robertyt33/TinyTapeout-ECE298A/Simulations/Pre-Layout/SPICE Simulation.pdf

# Pre-layout

## Step 0. Baseline Analysis

*Need PDK to get more precise simulation, and fine tune parameters, PDK was not working on my computer for some reason
Wpd = 0.84, Wax = 0.42, Wpu = 0.42
(Access width: 0.42; PMOS: 0.42; NMOS: 0.84, CR=2.0, PR=1.0)

### 1bit_sram_read.spice

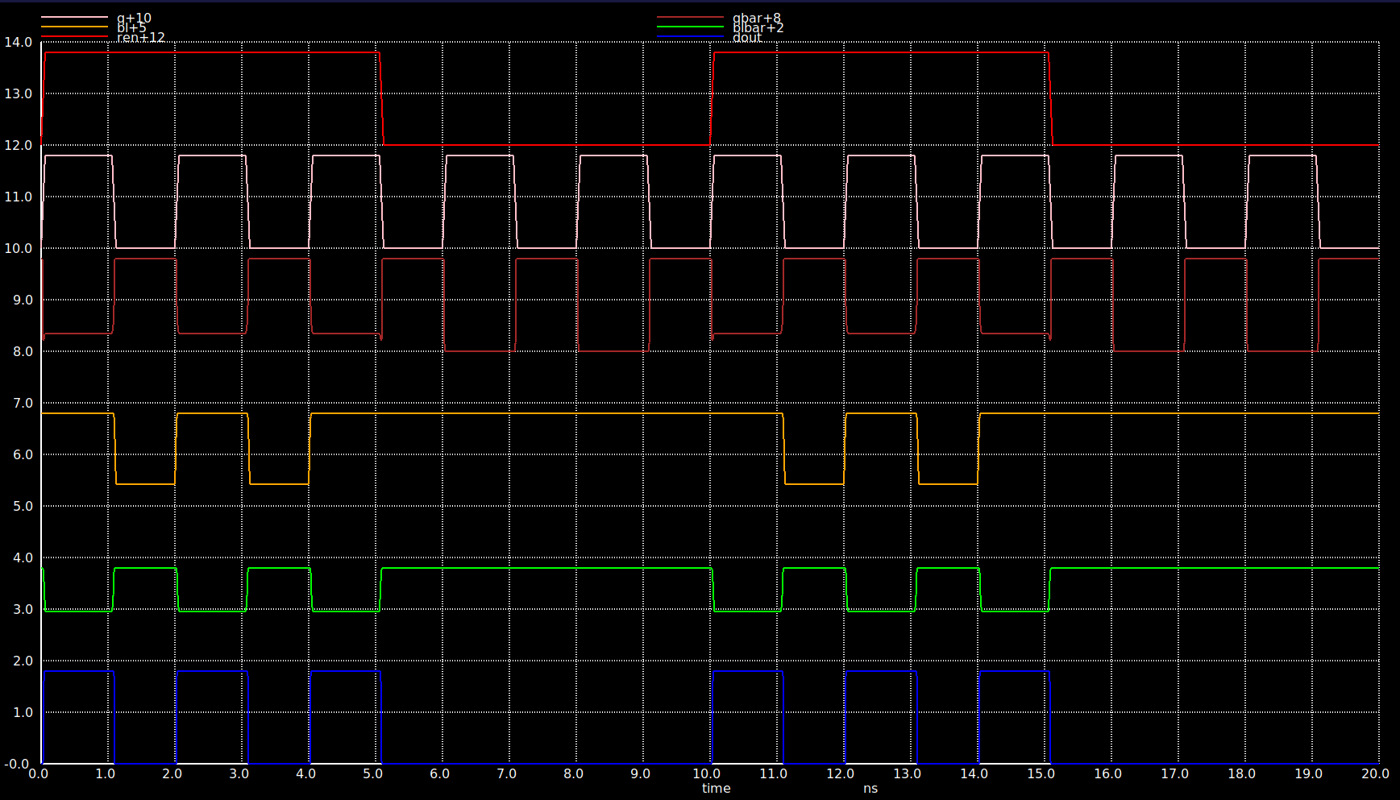
[picture p16: figure]
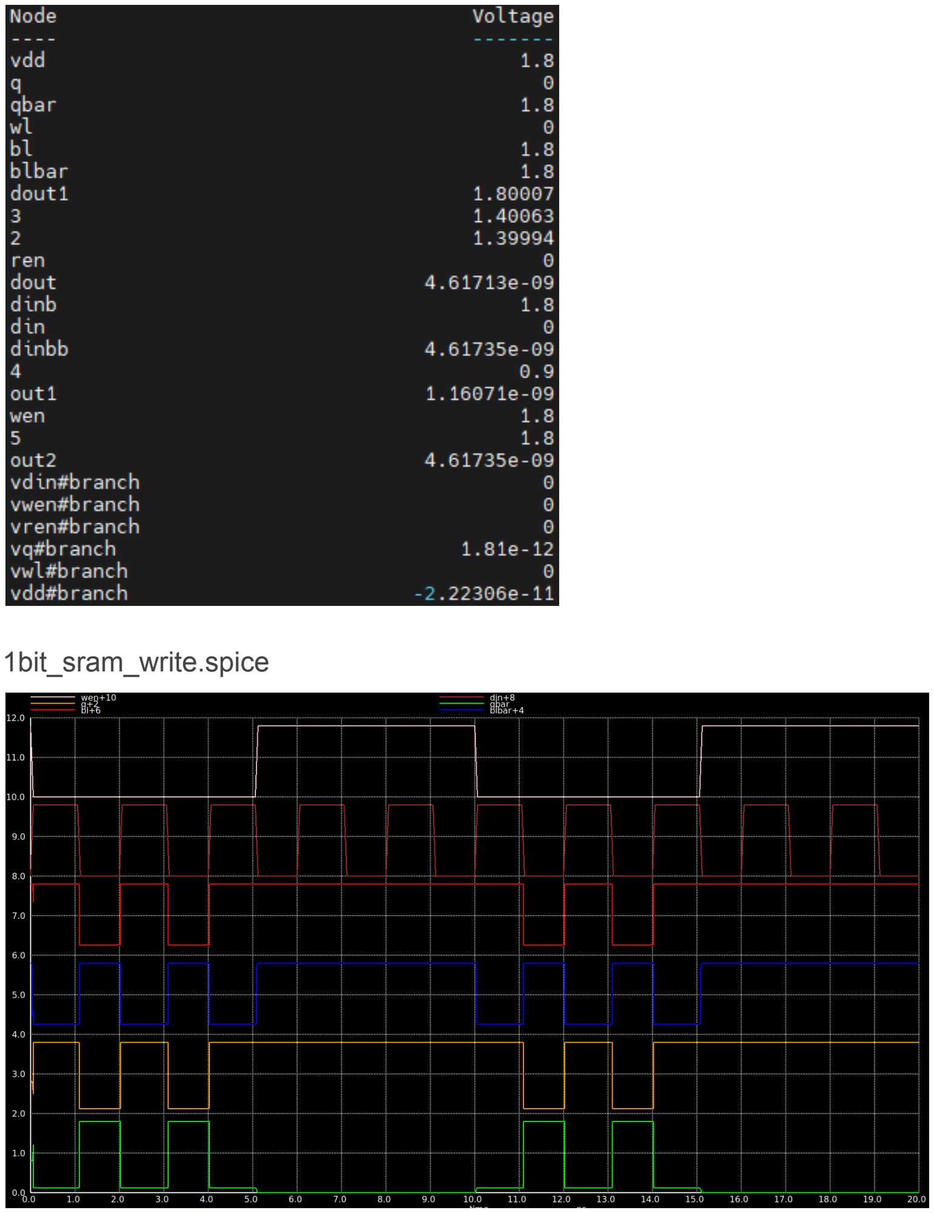
[picture p17: page 2]

### 1bit_sram_write.spice

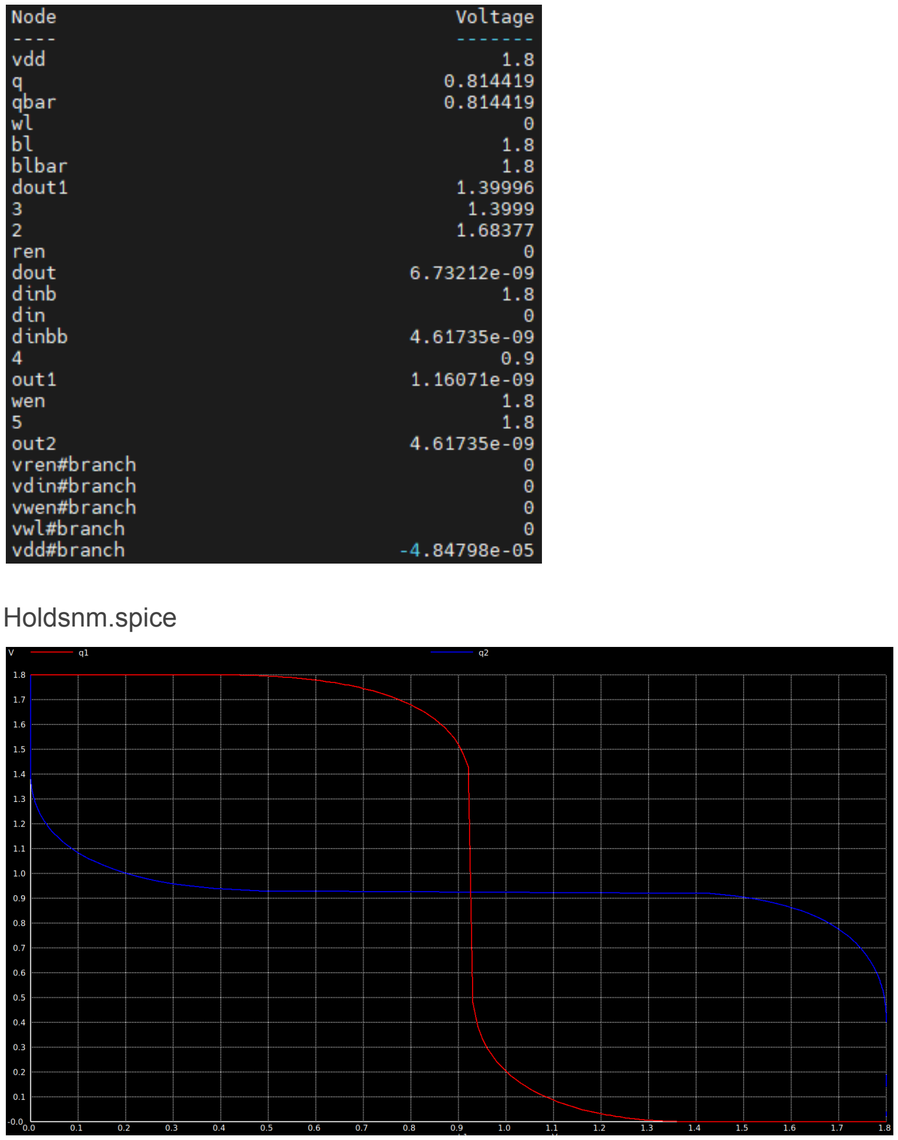
[picture p18: page 3]

### Holdsnm.spice

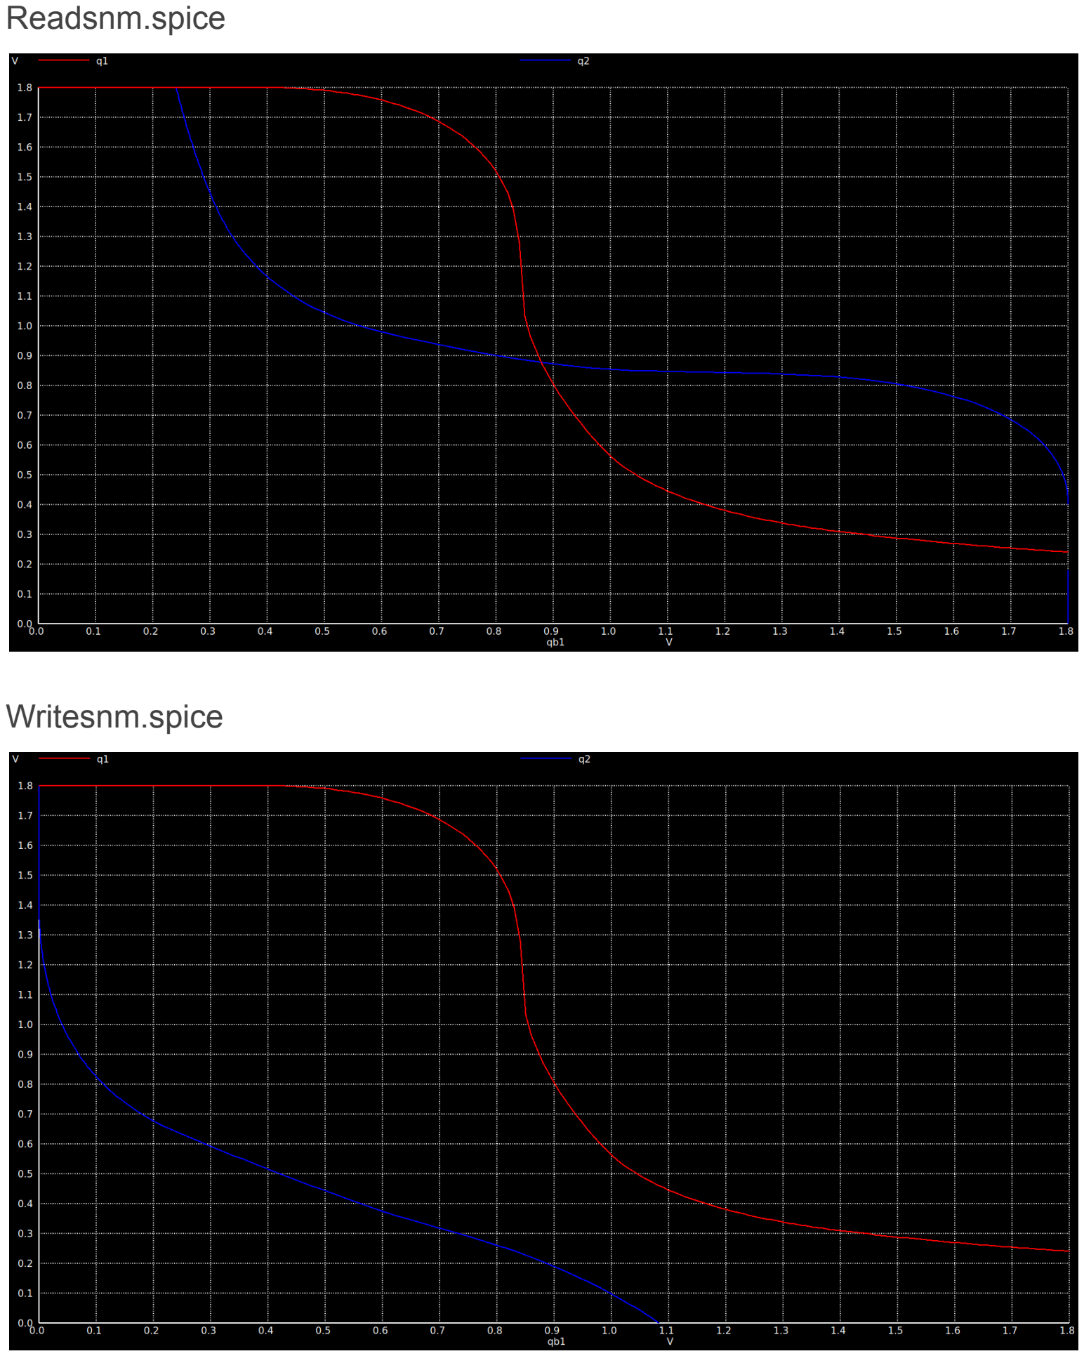
[picture p19: page 4]

### Readsnm.spice

### Writesnm.spice

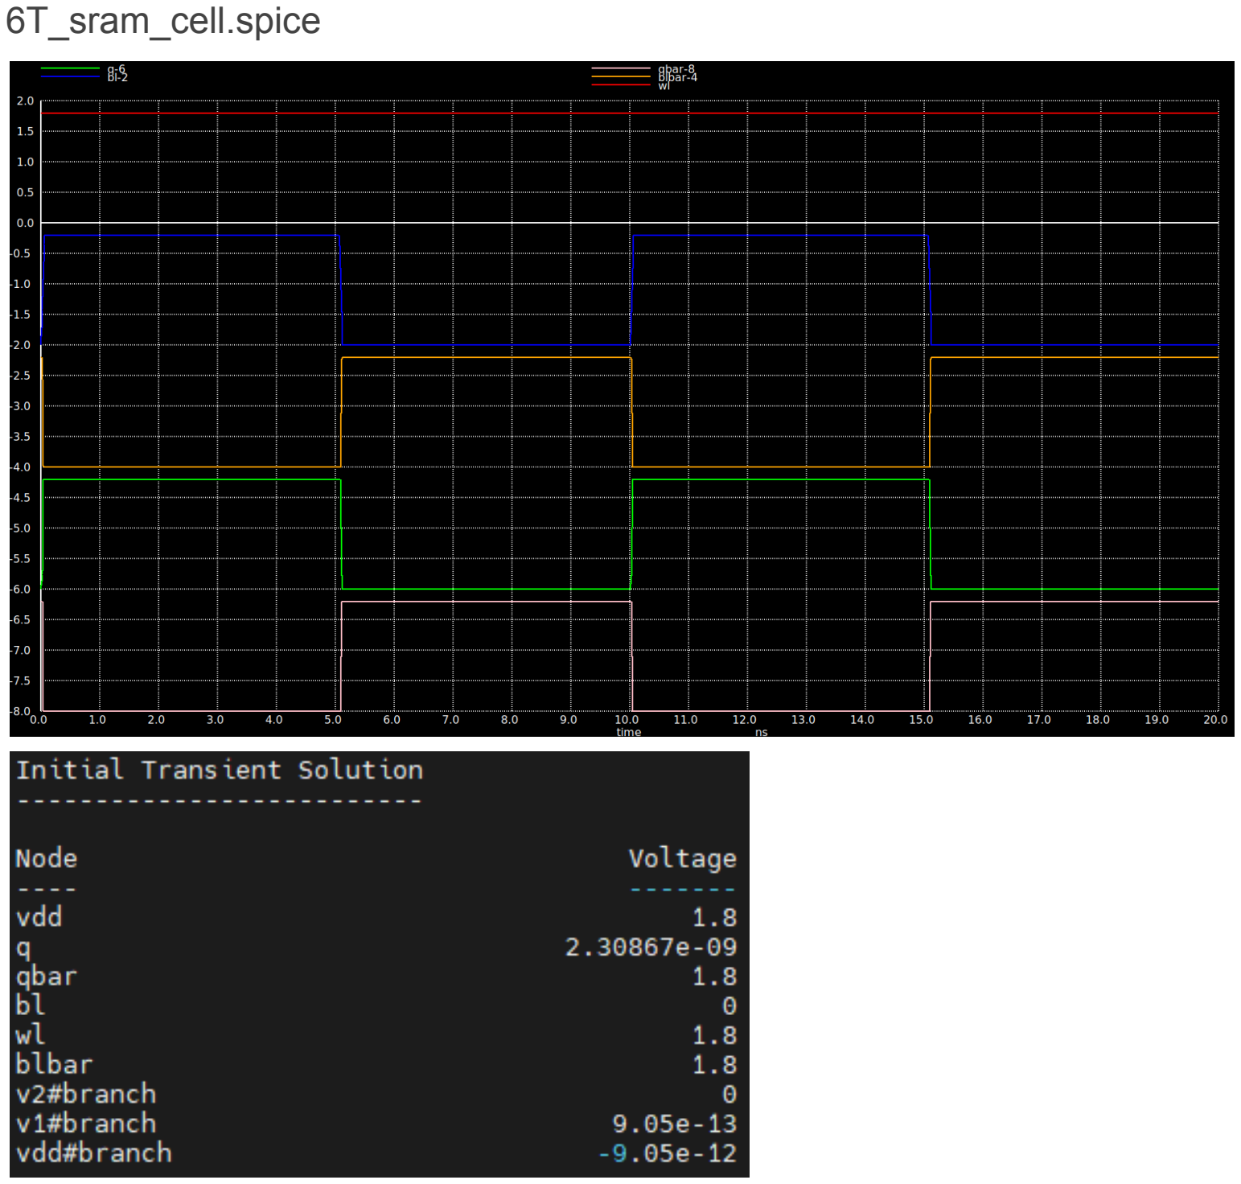
[picture p20: page 5]

### 6T_sram_cell.spice
