robertyt33/TinyTapeout-ECE298A/docs/image.png

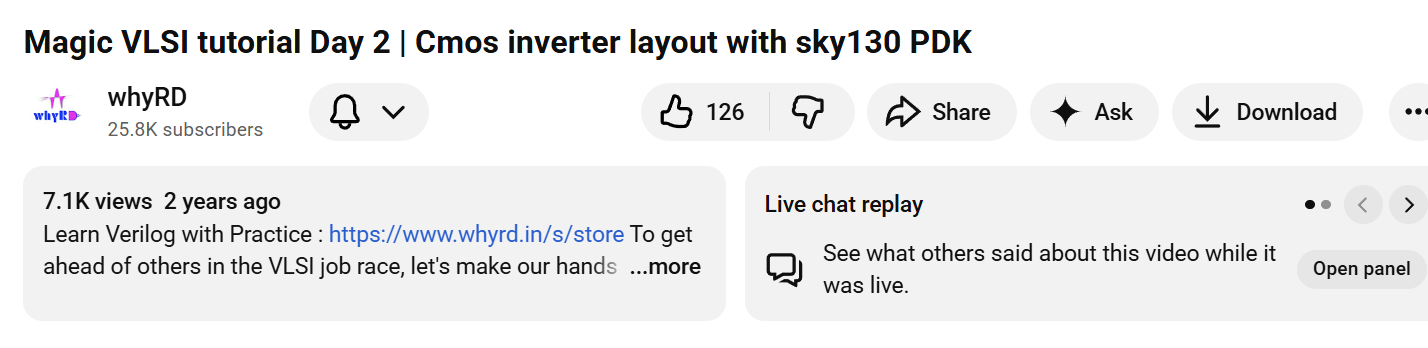
docs/image.png
