robertyt33/TinyTapeout-ECE298A/Schematics/holdsnm.png

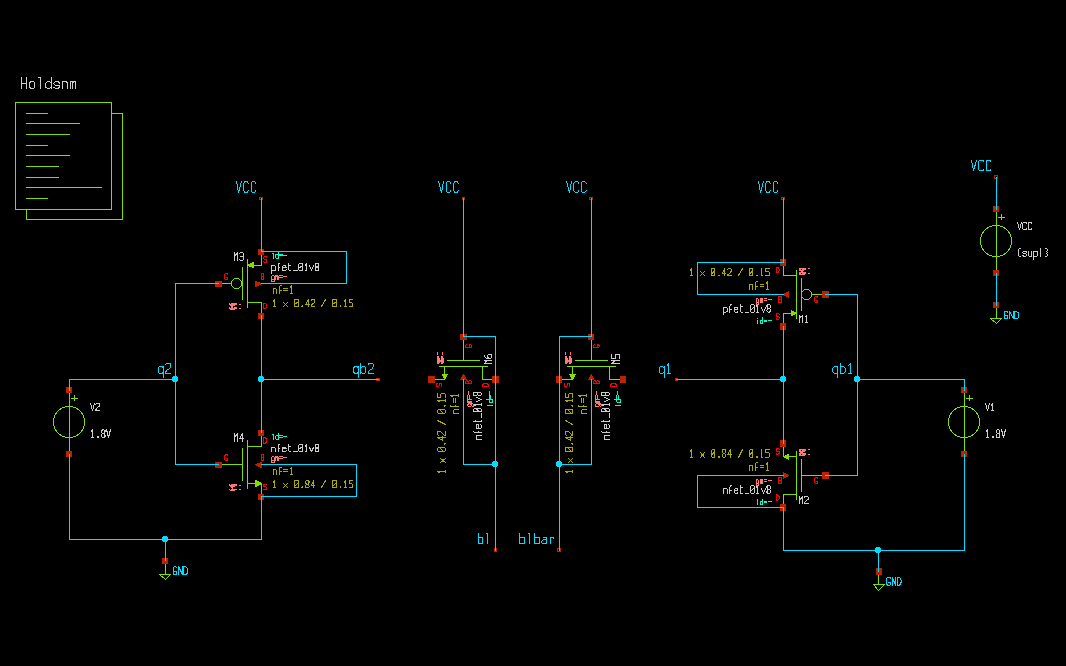
Schematics/holdsnm.png
