robertyt33/TinyTapeout-ECE298A/Simulations/Post-Layout/Timing/plot_read_timing_500f.png

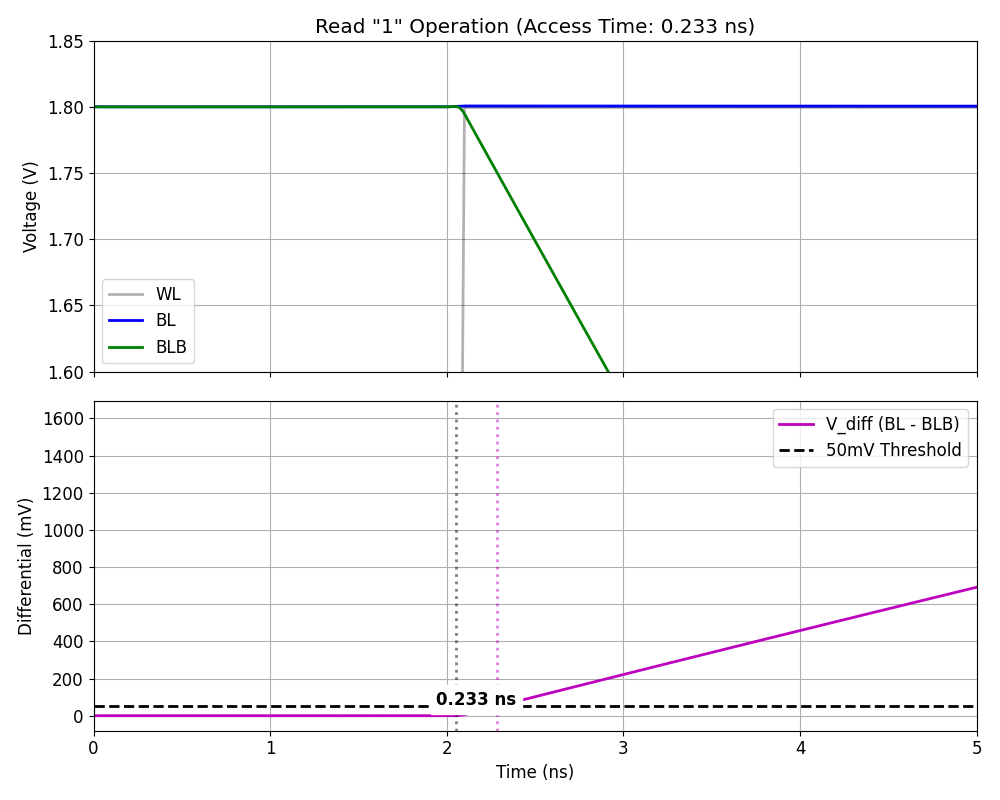
Simulations/Post-Layout/Timing/plot_read_timing_500f.png
