robertyt33/TinyTapeout-ECE298A/Simulations/Post-Layout/Timing/plot_read_timing_1000f.png

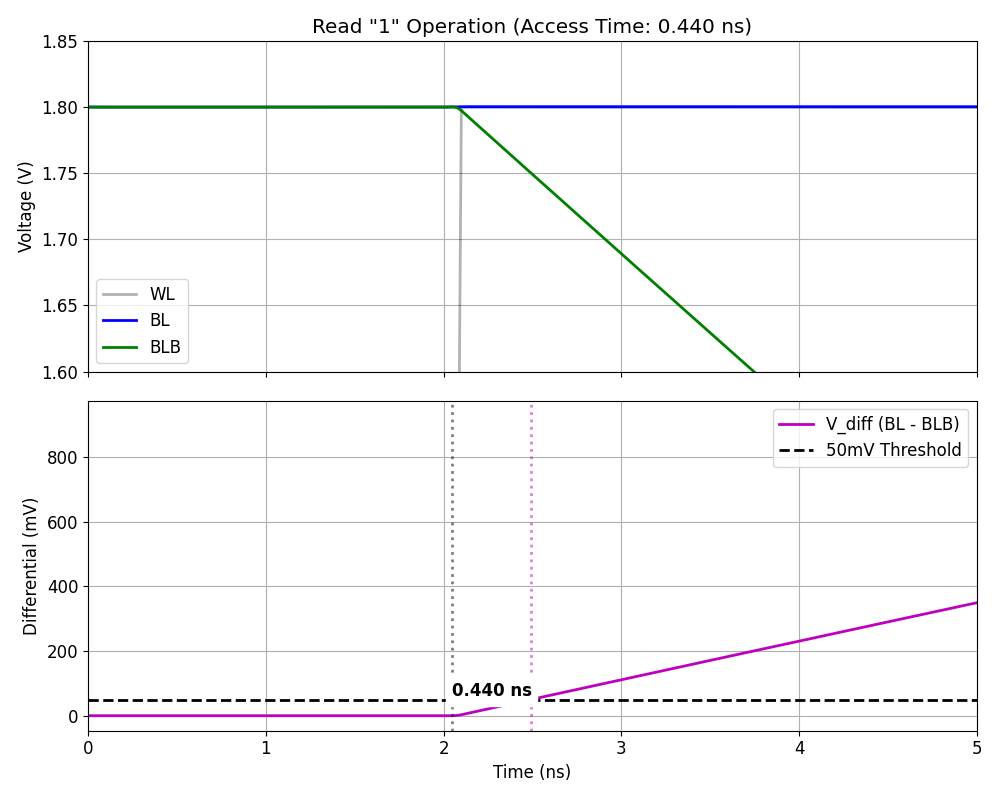
Simulations/Post-Layout/Timing/plot_read_timing_1000f.png
