robertyt33/TinyTapeout-ECE298A/Simulations/Post-Layout/Testbench/6T_SRAM_1bit.spice

* NGSPICE file created from 6T_SRAM_1bit.ext - technology: sky130A

.subckt x6T_SRAM_1bit bl blbar qbar q vdd gnd wl
X0 qbar q gnd gnd sky130_fd_pr__nfet_01v8 ad=0.3528 pd=2.52 as=0.3528 ps=2.52 w=0.84 l=0.18
X1 q wl bl gnd sky130_fd_pr__nfet_01v8 ad=0.1512 pd=1.56 as=0.1512 ps=1.56 w=0.42 l=0.24
X2 q qbar gnd gnd sky130_fd_pr__nfet_01v8 ad=0.3528 pd=2.52 as=0.3528 ps=2.52 w=0.84 l=0.18
X3 qbar q vdd vdd sky130_fd_pr__pfet_01v8 ad=0.1764 pd=1.68 as=0.1764 ps=1.68 w=0.42 l=0.18
X4 qbar wl blbar gnd sky130_fd_pr__nfet_01v8 ad=0.1512 pd=1.56 as=0.1512 ps=1.56 w=0.42 l=0.24
X5 q qbar vdd vdd sky130_fd_pr__pfet_01v8 ad=0.1764 pd=1.68 as=0.1764 ps=1.68 w=0.42 l=0.18
C0 qbar wl 0.02135f
C1 vdd wl 0
C2 blbar wl 0.07543f
C3 q wl 0.01898f
C4 bl wl 0.07277f
C5 vdd qbar 0.18118f
C6 blbar qbar 0.18685f
C7 vdd blbar 0.10496f
C8 q qbar 0.27548f
C9 q vdd 0.17955f
C10 bl qbar 0.01553f
C11 q blbar 0.02758f
C12 bl vdd 0.11511f
C13 bl blbar 0.08501f
C14 bl q 0.14686f
C15 blbar gnd 0.43635f
C16 bl gnd 0.45248f
C17 wl gnd 0.68819f
C18 q gnd 0.85361f
C19 qbar gnd 0.64243f
C20 vdd gnd 0.85602f
.ends
