robertyt33/TinyTapeout-ECE298A/(commit log)

2025-12-04 Reorganize and uploading documents to the repo for presentation
    [holdsnm.sch, readsnm.sch, writesnm.sch]
2025-12-04 Update schematic diagram for 6T SRAM
    Removed old schematic images and added a new schematic diagram for 6T SRAM.
